roguecat0/Wheel-Display-POV/PCB/Schematic_pov-display-IB3.pdf

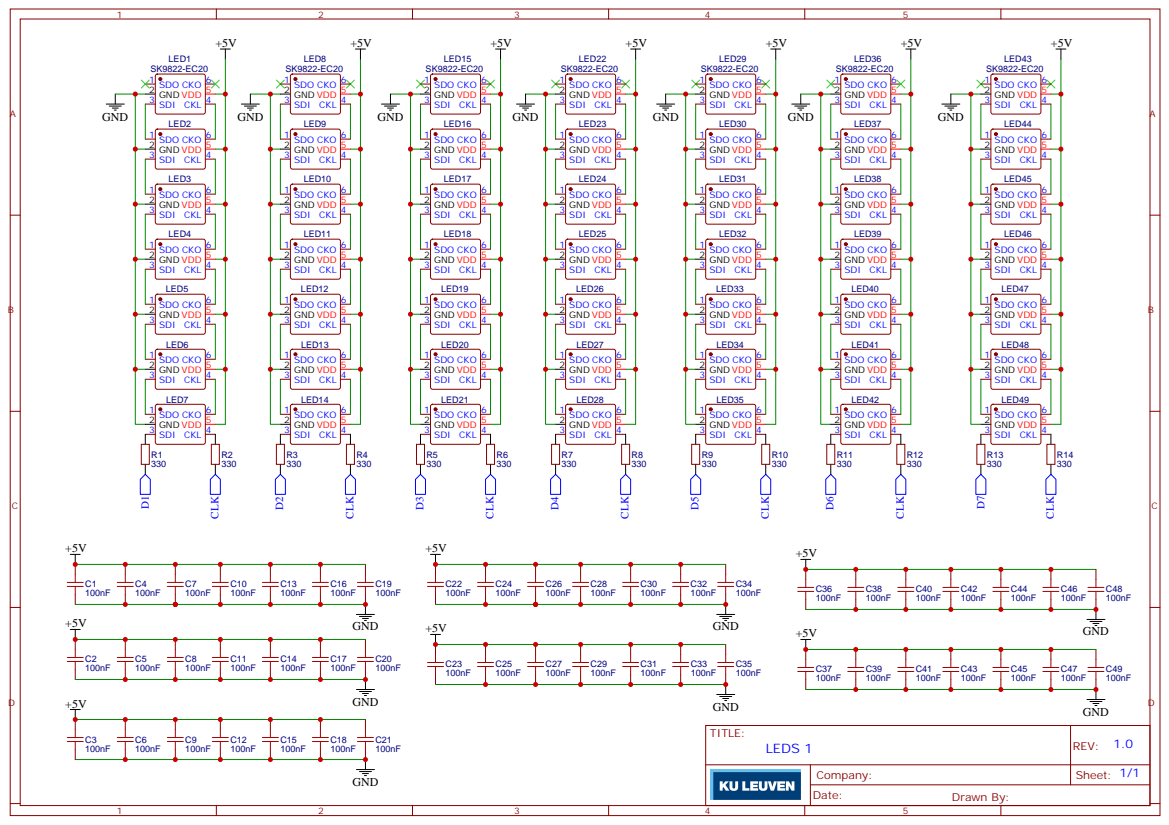
[picture p1: page 1]

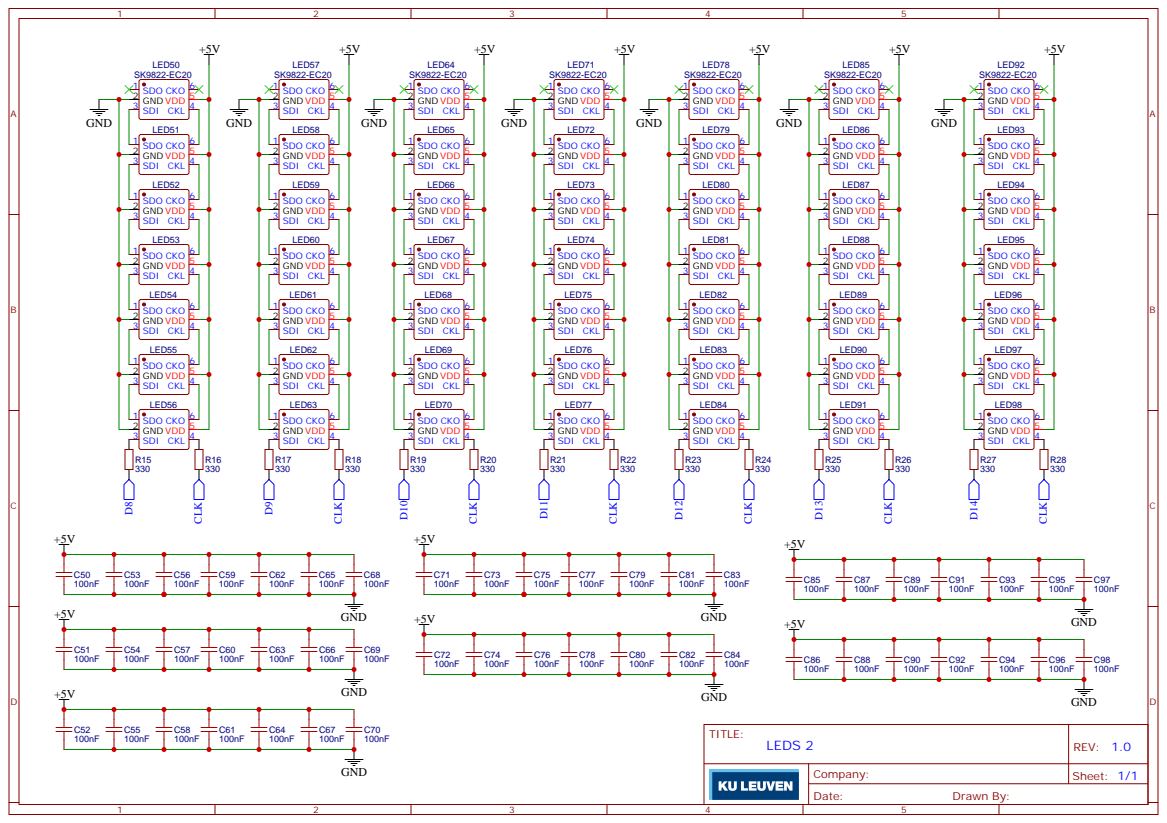
[picture p2: page 2]

## USB input

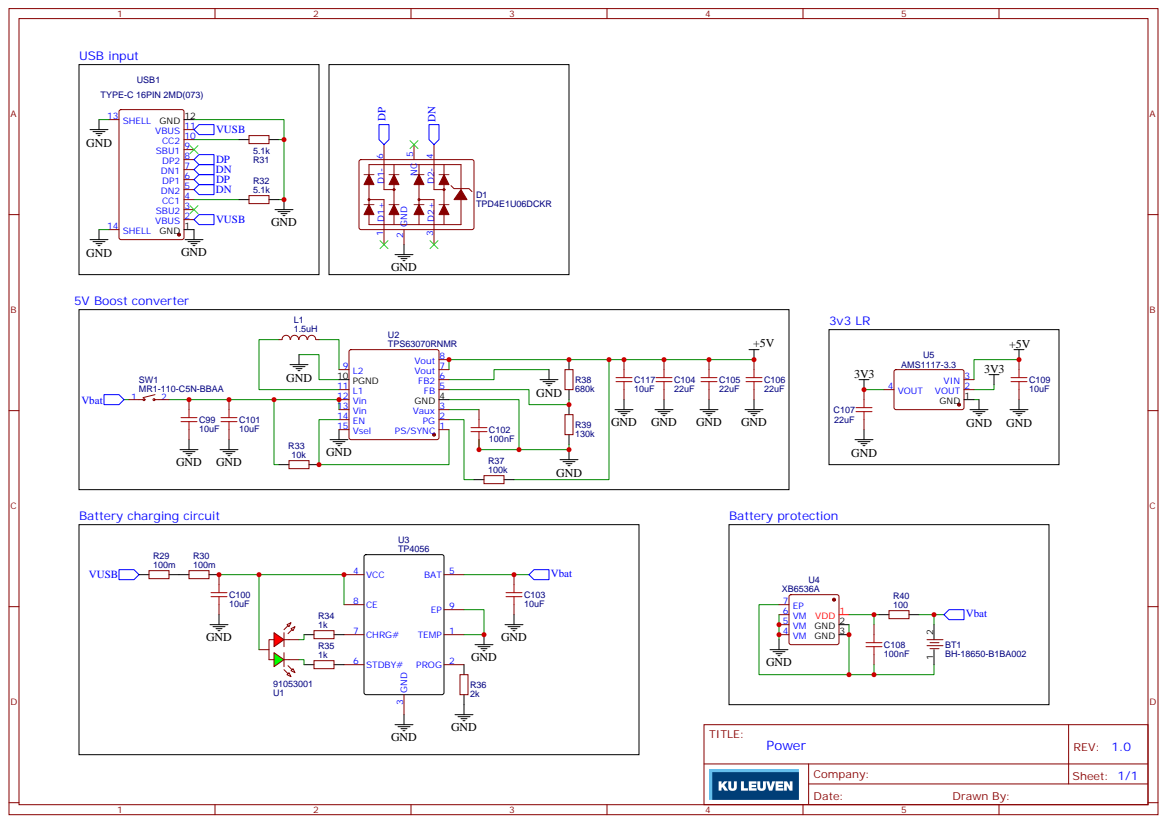
[picture p3: page 3]

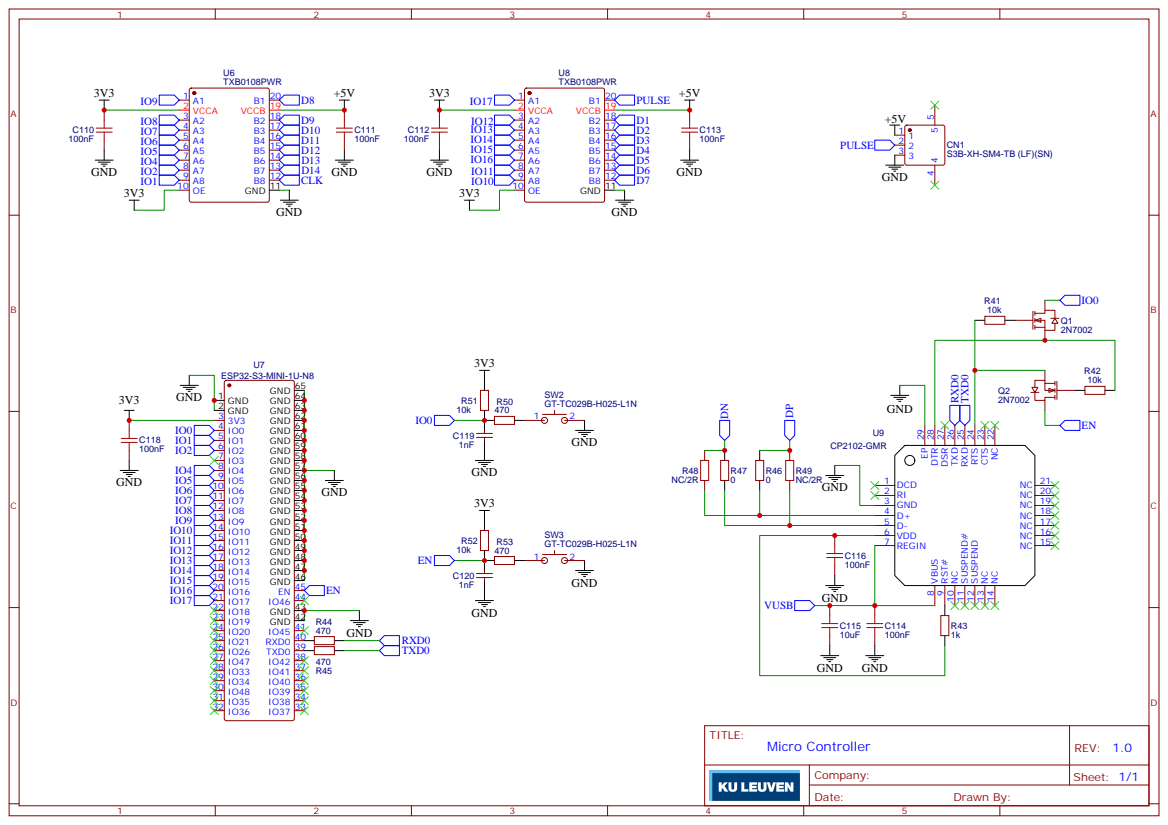
[picture p4: page 4]

NC 22 CTS 23 RTS 24 RXD 25 TXD 26 DSR 27 DTR 28 EP 29
