roguecat0/Wheel-Display-POV/(commit log)

2023-02-23 made picture encoder
2023-04-03 Added arduino code
2023-04-10 send with socket
2023-04-20 socket send with json
2023-04-21 jannes arduinocode werkend
2023-05-12 encoder update
